cybdann/Hexapod/README.md

# Hexapod
A 6 six legged robot with 24 DoF, designed to be remotely controlled by an Android application.

Making of [Hexapod](https://youtu.be/HGF_E_Dyq9E).
