cybdann/Hexapod/MATLAB/horizontal.gif

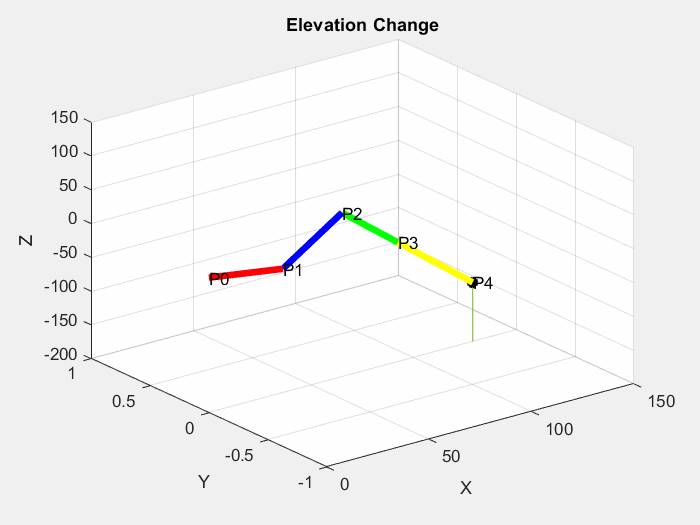
MATLAB/horizontal.gif
