cybdann/Hexapod/CAD Model/STL files/Body/BodyTopCasing2.stl

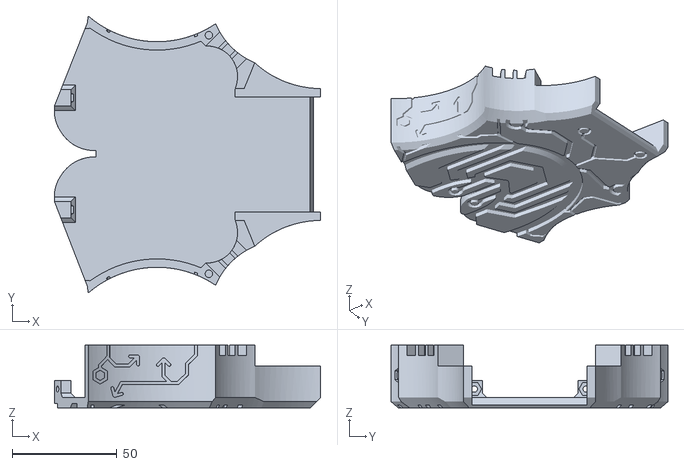
[picture p32: CAD file, 2022-01-12]
CAD Model/STL files/Body/BodyTopCasing2.stl
127.2 x 132.3 x 30.0
