cybdann/Hexapod/CAD Model/STL files/Leg Left Side/PistonTop.stl

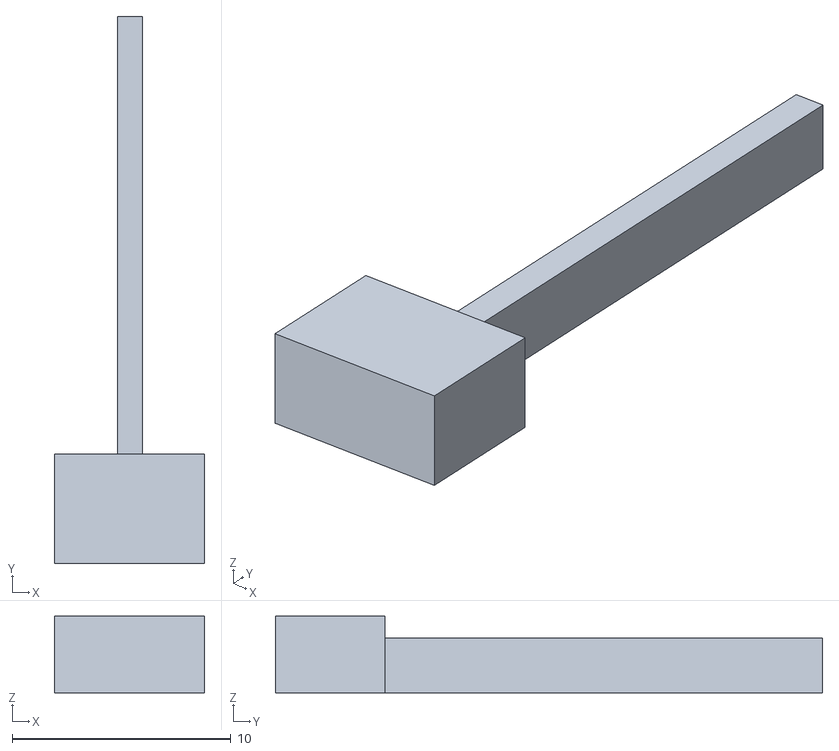
[picture p33: CAD file, 2022-01-12]
CAD Model/STL files/Leg Left Side/PistonTop.stl
6.85 x 25.0 x 3.50
