cybdann/Hexapod/CAD Model/STL files/Leg Right Side/PistonCasingTop.stl

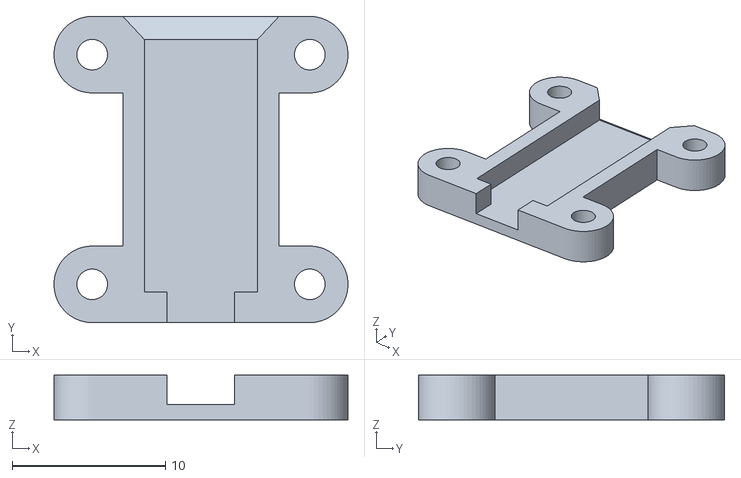
[picture p34: CAD file, 2022-01-12]
CAD Model/STL files/Leg Right Side/PistonCasingTop.stl
19.2 x 20.0 x 2.91
