cybdann/Hexapod/CAD Model/STL files/Body/BodyBotSup.stl

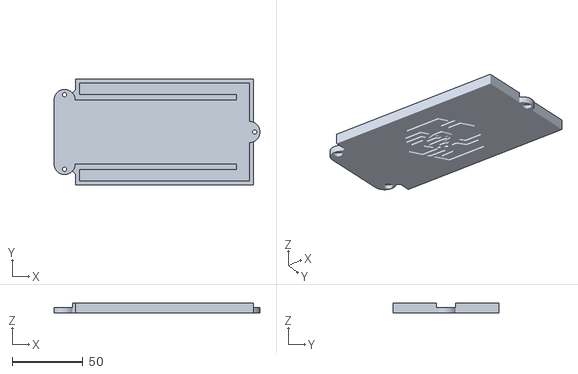
[picture p35: CAD file, 2022-01-12]
CAD Model/STL files/Body/BodyBotSup.stl
145.7 x 75.2 x 7.00
