cybdann/Hexapod/CAD Model/STL files/Leg Left Side/PistonBot.stl

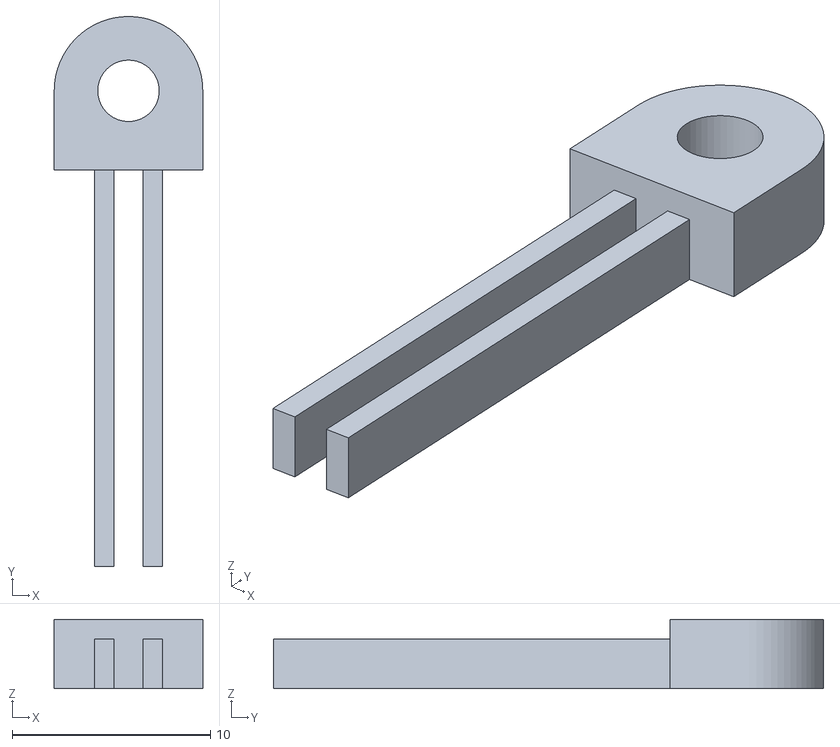
[picture p36: CAD file, 2022-01-12]
CAD Model/STL files/Leg Left Side/PistonBot.stl
7.50 x 27.8 x 3.50
