cybdann/Hexapod/CAD Model/STL files/Leg Right Side/PatellaTop.stl

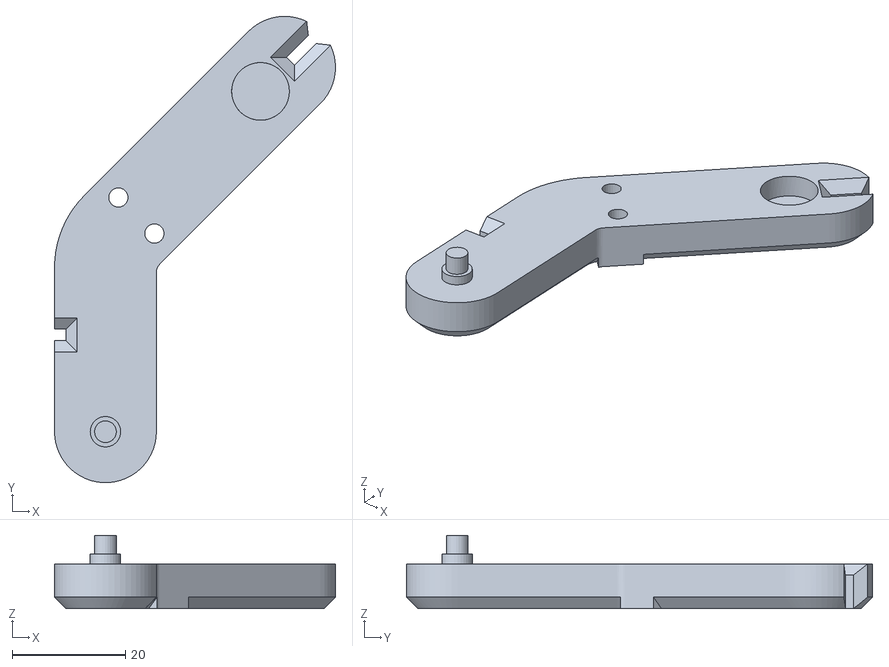
[picture p37: CAD file, 2022-01-12]
CAD Model/STL files/Leg Right Side/PatellaTop.stl
49.6 x 82.3 x 12.9
