cybdann/Hexapod/CAD Model/STL files/Body/PCBSupportTop.stl

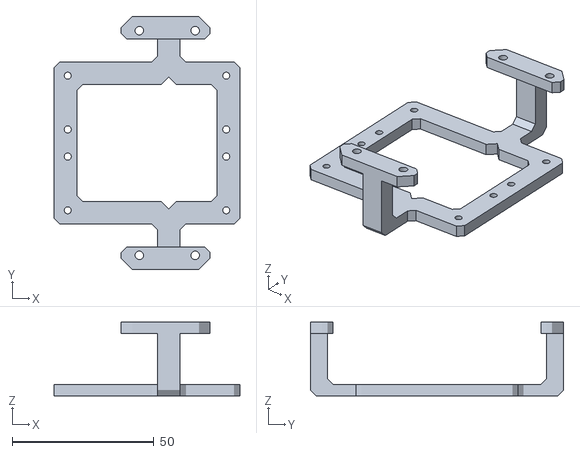
[picture p38: CAD file, 2022-01-12]
CAD Model/STL files/Body/PCBSupportTop.stl
65.6 x 89.4 x 26.0
