cybdann/Hexapod/CAD Model/STL files/Leg Right Side/Fibula.stl

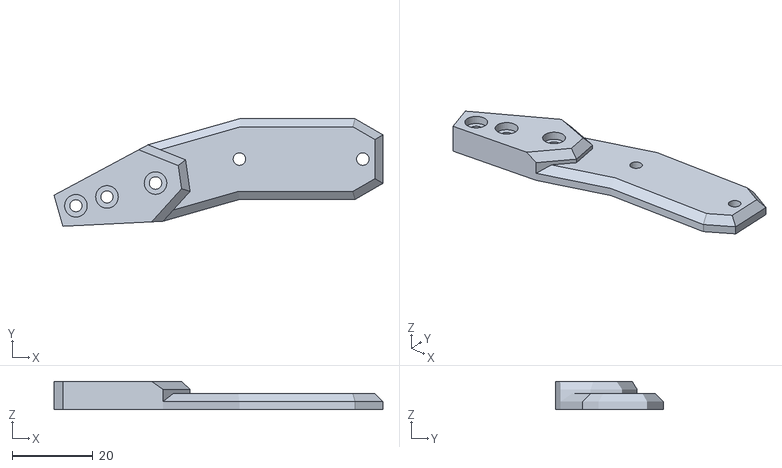
[picture p39: CAD file, 2022-01-12]
CAD Model/STL files/Leg Right Side/Fibula.stl
81.5 x 26.6 x 7.00
