cybdann/Hexapod/CAD Model/STL files/Body/BodyTopCasing1.stl

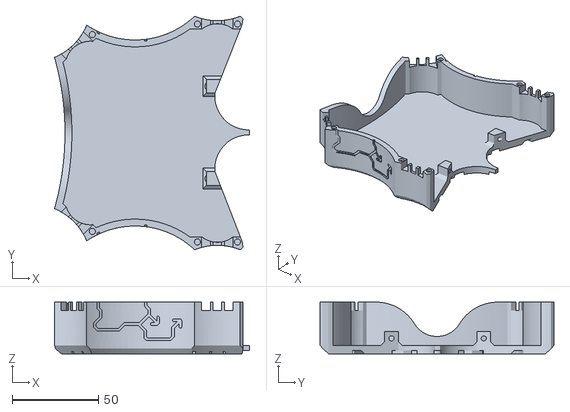
[picture p40: CAD file, 2022-01-12]
CAD Model/STL files/Body/BodyTopCasing1.stl
113.0 x 135.3 x 30.0
