cybdann/Hexapod/CAD Model/STL files/Body/BodyBot2.stl

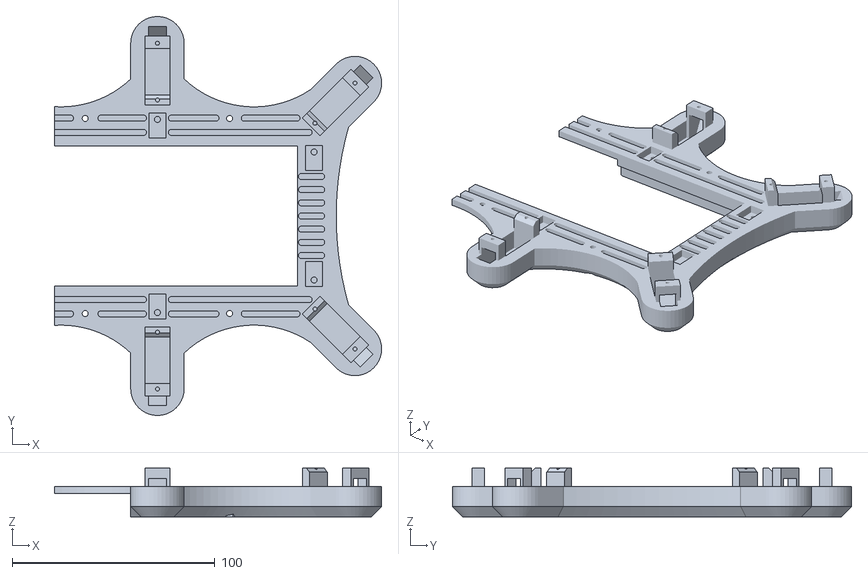
[picture p41: CAD file, 2022-01-12]
CAD Model/STL files/Body/BodyBot2.stl
161.6 x 197.0 x 24.0
