cybdann/Hexapod/CAD Model/STL files/Leg Left Side/Tibia Joint.stl

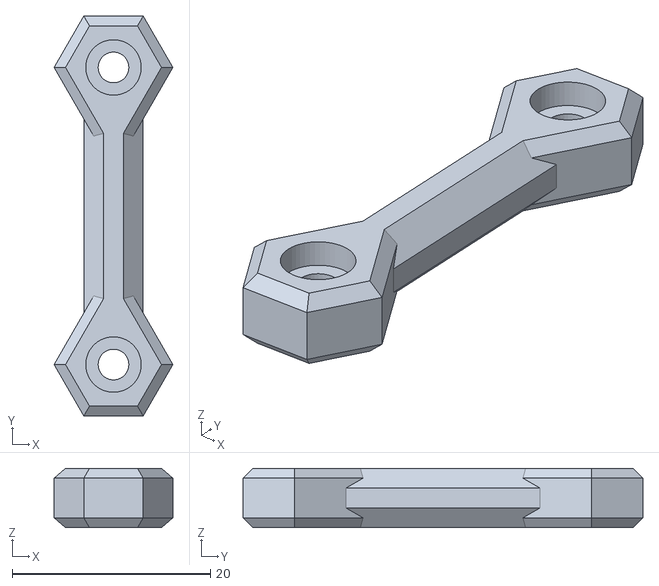
[picture p42: CAD file, 2022-01-12]
CAD Model/STL files/Leg Left Side/Tibia Joint.stl
12.0 x 40.4 x 6.00
