cybdann/Hexapod/CAD Model/STL files/Leg Right Side/FermurSupportSup.stl

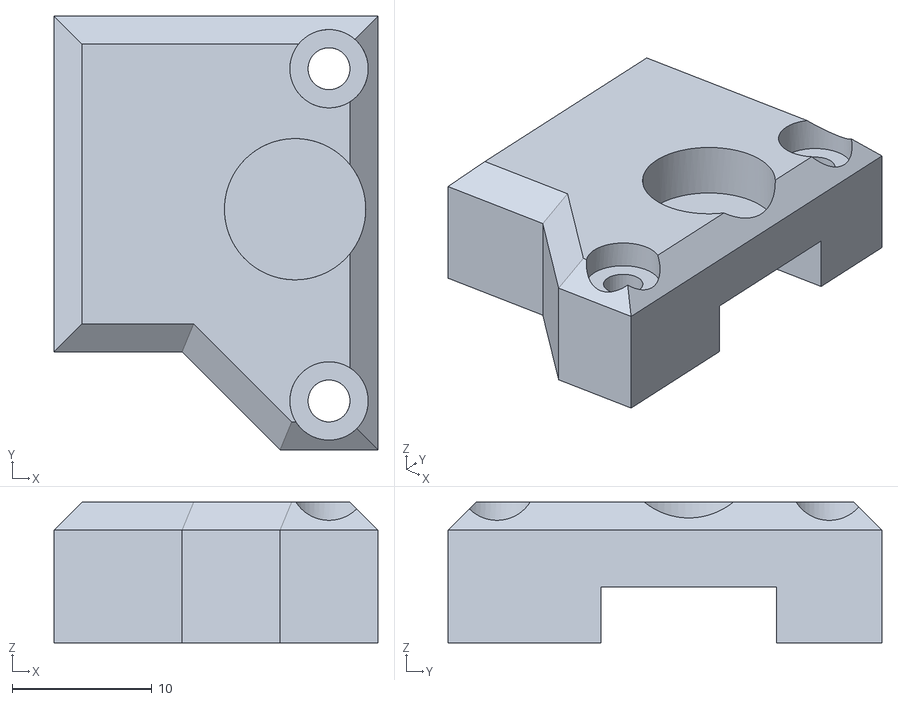
[picture p43: CAD file, 2022-01-12]
CAD Model/STL files/Leg Right Side/FermurSupportSup.stl
23.1 x 31.0 x 10.1
