cybdann/Hexapod/CAD Model/STL files/Body/BodyMid.stl

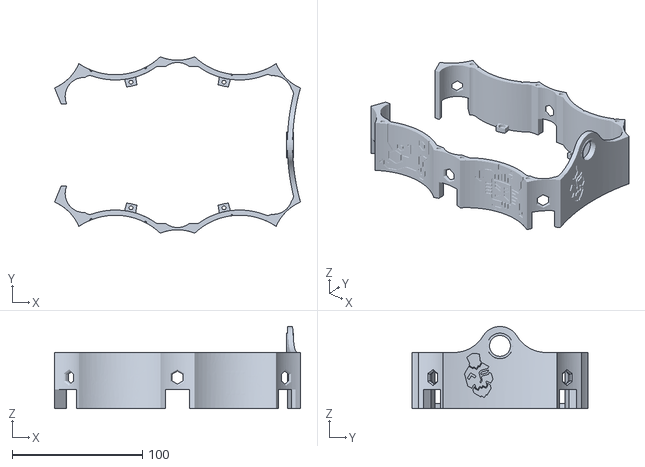
[picture p44: CAD file, 2022-01-12]
CAD Model/STL files/Body/BodyMid.stl
188.7 x 135.3 x 62.9
