cybdann/Hexapod/CAD Model/STL files/Leg Right Side/PatellaBot.stl

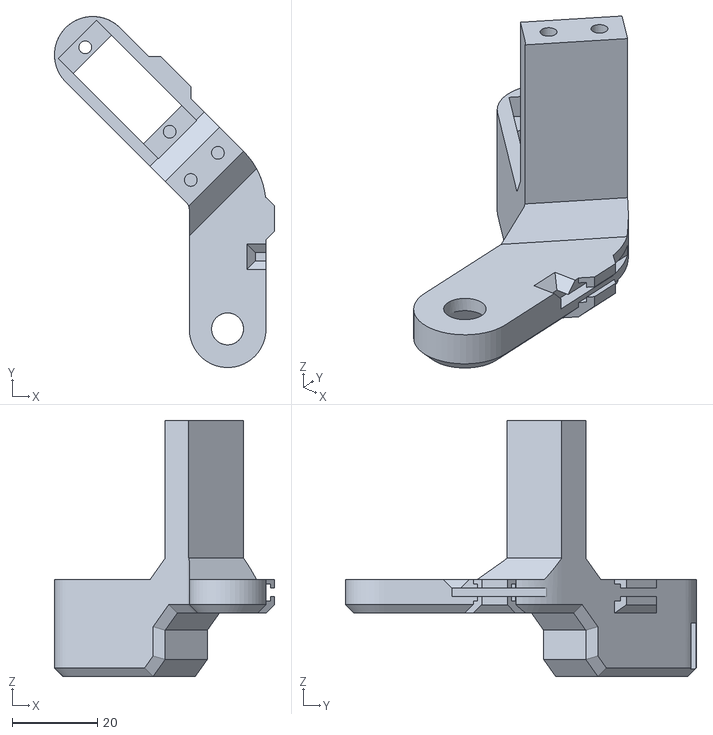
[picture p45: CAD file, 2022-01-12]
CAD Model/STL files/Leg Right Side/PatellaBot.stl
51.6 x 82.3 x 60.1
