cybdann/Hexapod/CAD Model/STL files/Body/BodyBot1.stl

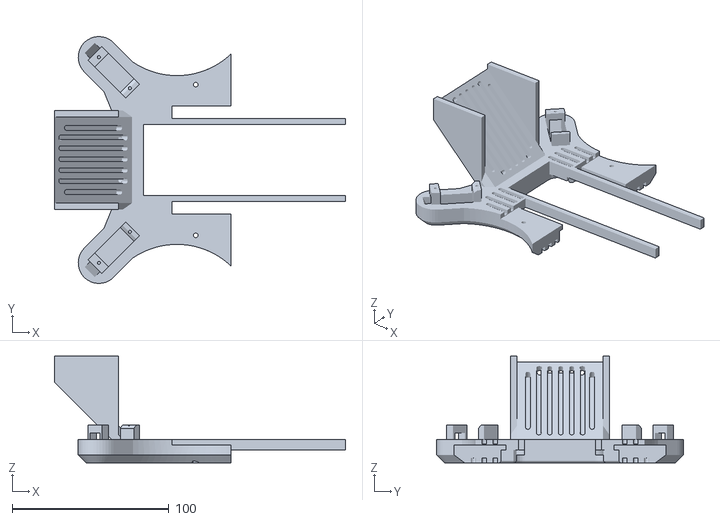
[picture p46: CAD file, 2022-01-12]
CAD Model/STL files/Body/BodyBot1.stl
185.8 x 157.6 x 68.0
