cybdann/Hexapod/CAD Model/STL files/Leg Left Side/FermurSupportLeft.stl

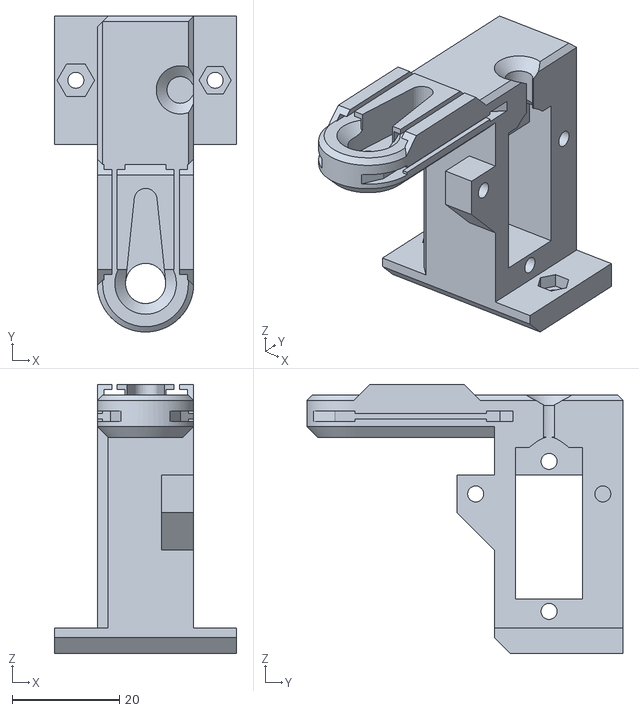
[picture p47: CAD file, 2022-01-12]
CAD Model/STL files/Leg Left Side/FermurSupportLeft.stl
34.0 x 59.0 x 50.3
