cybdann/Hexapod/CAD Model/STL files/Leg Right Side/PistonCasingPivot.stl

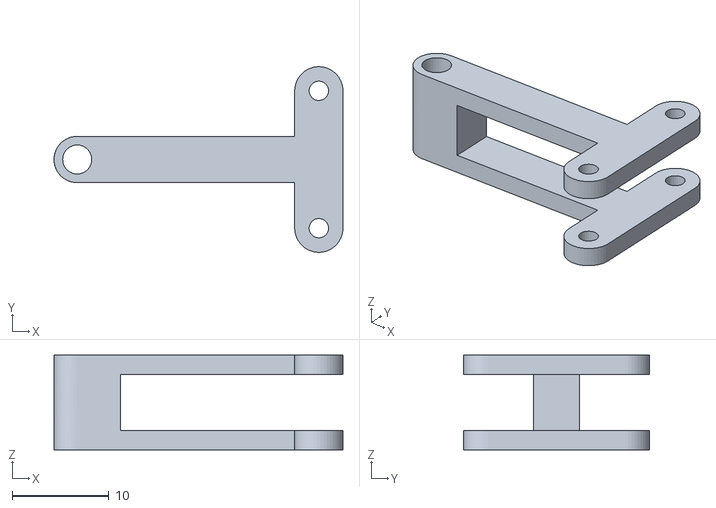
[picture p48: CAD file, 2022-01-12]
CAD Model/STL files/Leg Right Side/PistonCasingPivot.stl
29.9 x 19.2 x 9.81
