cybdann/Hexapod/CAD Model/STL files/Body/PCBSupportBot.stl

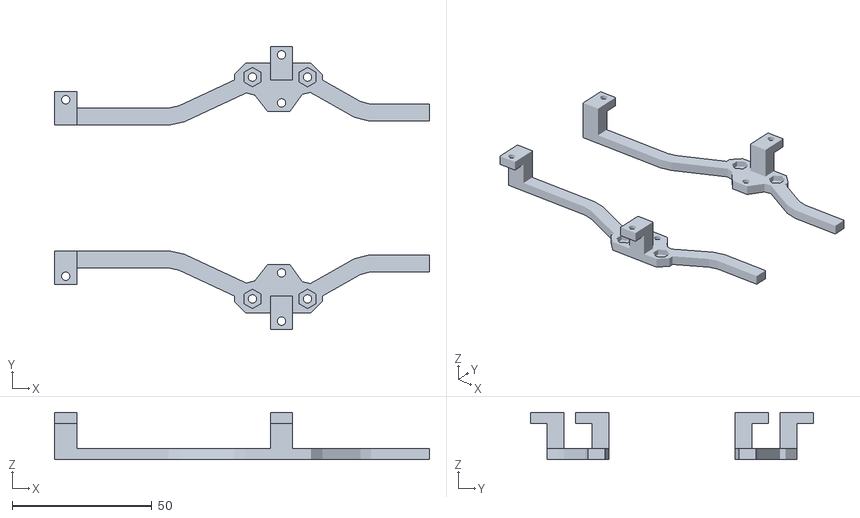
[picture p49: CAD file, 2022-01-12]
CAD Model/STL files/Body/PCBSupportBot.stl
134.3 x 101.4 x 17.0
