cybdann/Hexapod/CAD Model/STL files/Leg Right Side/FemurSupportBot.stl

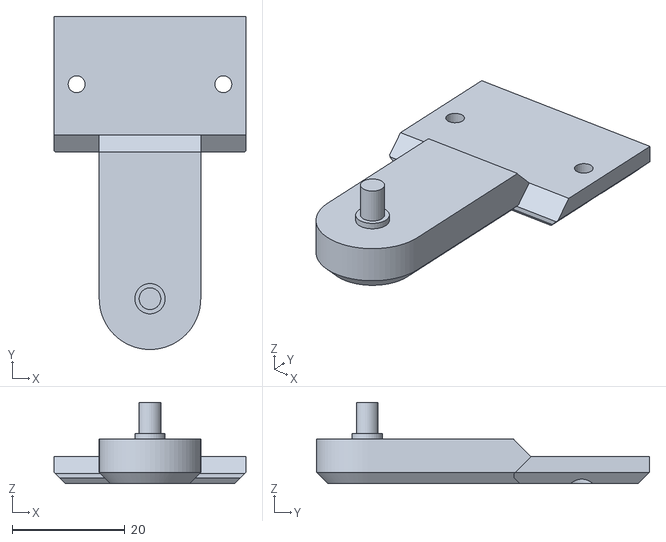
[picture p50: CAD file, 2022-01-12]
CAD Model/STL files/Leg Right Side/FemurSupportBot.stl
34.0 x 59.0 x 14.4
