cybdann/Hexapod/CAD Model/STL files/Leg Right Side/Tarsus.stl

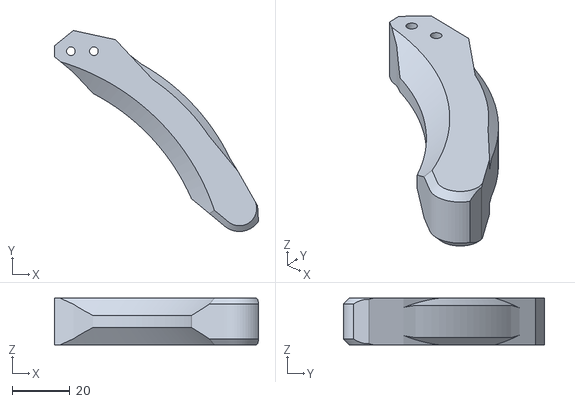
[picture p51: CAD file, 2022-01-12]
CAD Model/STL files/Leg Right Side/Tarsus.stl
70.9 x 69.8 x 16.2
