cybdann/Hexapod/CAD Model/STL files/Leg Right Side/TibiaTop.stl

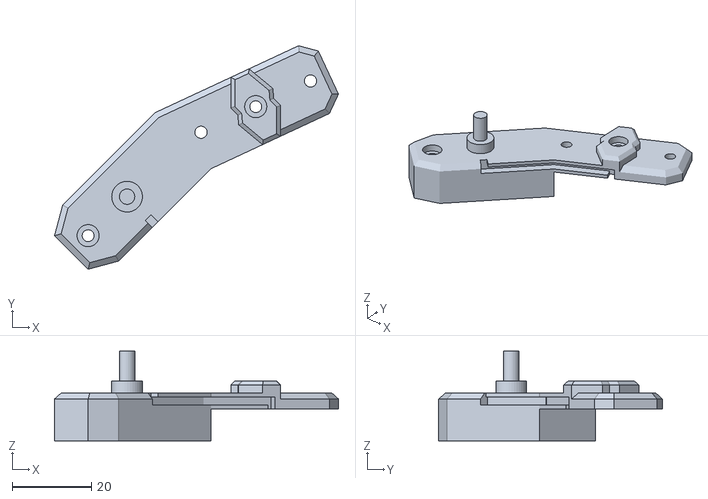
[picture p52: CAD file, 2022-01-12]
CAD Model/STL files/Leg Right Side/TibiaTop.stl
71.7 x 56.5 x 22.7
