cybdann/Hexapod/CAD Model/STL files/Leg Left Side/TibiaBotLeft.stl

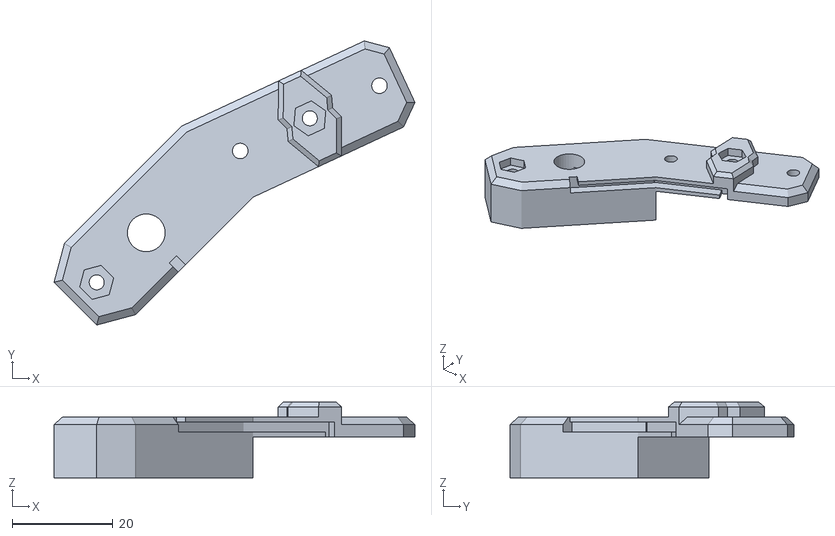
[picture p53: CAD file, 2022-01-12]
CAD Model/STL files/Leg Left Side/TibiaBotLeft.stl
71.7 x 56.5 x 15.1
