cybdann/Hexapod/(list of files, cad)

Other CAD files:
CAD Model/Inventor files/Templates/English/ANSI (in).dwg
CAD Model/Inventor files/Templates/Metric/ISO.dwg
CAD Model/Inventor files/Templates/standard.dwg
CAD Model/Inventor files/Templates/Metric/ANSI (mm).dwg
CAD Model/Inventor files/Templates/Metric/DIN.dwg
CAD Model/STL files/Leg Left Side/PatellaTopLeft.stl
CAD Model/Inventor files/Templates/Metric/BSI.dwg
CAD Model/STL files/Leg Right Side/PistonCasingBot.stl
CAD Model/Inventor files/Templates/Metric/JIS.dwg
CAD Model/Inventor files/Templates/Metric/GOST.dwg
CAD Model/STL files/Leg Left Side/FibulaBot.stl
CAD Model/Inventor files/Templates/Metric/GB.dwg
CAD Model/STL files/Leg Left Side/FermurSupportSupLeft.stl
CAD Model/STL files/Leg Left Side/PatellaBotLeft.stl
CAD Model/STL files/Leg Right Side/FibulaBot.stl
CAD Model/STL files/Leg Left Side/PistonCasingBot.stl
CAD Model/STL files/Leg Right Side/FermurSupport.stl
CAD Model/STL files/Leg Left Side/FemurSupportBotLeft.stl
CAD Model/STL files/Leg Right Side/TibiaBot.stl
CAD Model/STL files/Leg Left Side/TibiaTopLeft.stl
CAD Model/Inventor files/12Channel PWM.ipt
CAD Model/Inventor files/Bearing F 623 GB_T 7218-1995.ipt
CAD Model/Inventor files/Bearing FSN 718_5 GB_T 7218-1995.ipt
CAD Model/Inventor files/Bearing1.iam
CAD Model/Inventor files/Bearing1Left.iam
CAD Model/Inventor files/Bearing1Left1.iam
CAD Model/Inventor files/Bearing2.iam
CAD Model/Inventor files/Bearing2Left.iam
CAD Model/Inventor files/Bearing2Left1.iam
CAD Model/Inventor files/Bearing3.iam
CAD Model/Inventor files/Bearing4.iam
CAD Model/Inventor files/Bearing5.iam
CAD Model/Inventor files/Bearing6.iam
CAD Model/Inventor files/BodyBot.iam
CAD Model/Inventor files/BodyBot1.ipt
CAD Model/Inventor files/BodyBot2.ipt
CAD Model/Inventor files/BodyBotSup.ipt
CAD Model/Inventor files/BodyCasing.iam
CAD Model/Inventor files/BodyTop2.ipt
CAD Model/Inventor files/BodyTopCasing1.ipt
CAD Model/Inventor files/BodyTopCasing2.ipt
CAD Model/Inventor files/Bolted Connection1.iam
CAD Model/Inventor files/Bolted Connection10.iam
CAD Model/Inventor files/Bolted Connection10Left.iam
CAD Model/Inventor files/Bolted Connection10Left1.iam
CAD Model/Inventor files/Bolted Connection11.iam
CAD Model/Inventor files/Bolted Connection11Left.iam
CAD Model/Inventor files/Bolted Connection11Left1.iam
CAD Model/Inventor files/Bolted Connection12.iam
CAD Model/Inventor files/Bolted Connection12Left.iam
CAD Model/Inventor files/Bolted Connection12Left1.iam
CAD Model/Inventor files/Bolted Connection13.iam
CAD Model/Inventor files/Bolted Connection13Left.iam
CAD Model/Inventor files/Bolted Connection13Left1.iam
CAD Model/Inventor files/Bolted Connection14.iam
CAD Model/Inventor files/Bolted Connection14Left.iam
CAD Model/Inventor files/Bolted Connection14Left1.iam
CAD Model/Inventor files/Bolted Connection15.iam
CAD Model/Inventor files/Bolted Connection15Left.iam
CAD Model/Inventor files/Bolted Connection15Left1.iam
CAD Model/Inventor files/Bolted Connection16.iam
CAD Model/Inventor files/Bolted Connection16Left.iam
CAD Model/Inventor files/Bolted Connection16Left1.iam
CAD Model/Inventor files/Bolted Connection1Left.iam
CAD Model/Inventor files/Bolted Connection1Left1.iam
CAD Model/Inventor files/Bolted Connection2.iam
CAD Model/Inventor files/Bolted Connection2Left.iam
CAD Model/Inventor files/Bolted Connection2Left1.iam
CAD Model/Inventor files/Bolted Connection3.iam
CAD Model/Inventor files/Bolted Connection3Left.iam
CAD Model/Inventor files/Bolted Connection3Left1.iam
CAD Model/Inventor files/Bolted Connection4.iam
CAD Model/Inventor files/Bolted Connection4Left.iam
CAD Model/Inventor files/Bolted Connection4Left1.iam
CAD Model/Inventor files/Bolted Connection5.iam
CAD Model/Inventor files/Bolted Connection5Left.iam
CAD Model/Inventor files/Bolted Connection5Left1.iam
CAD Model/Inventor files/Bolted Connection6.iam
CAD Model/Inventor files/Bolted Connection6Left.iam
CAD Model/Inventor files/Bolted Connection6Left1.iam
CAD Model/Inventor files/Bolted Connection7.iam
CAD Model/Inventor files/Bolted Connection7Left.iam
CAD Model/Inventor files/Bolted Connection7Left1.iam
CAD Model/Inventor files/Bolted Connection8.iam
CAD Model/Inventor files/Bolted Connection8Left.iam
CAD Model/Inventor files/Bolted Connection8Left1.iam
CAD Model/Inventor files/Bolted Connection9.iam
CAD Model/Inventor files/Bolted Connection9Left.iam
CAD Model/Inventor files/Bolted Connection9Left1.iam
CAD Model/Inventor files/Compress Spring1.iam
CAD Model/Inventor files/Compress Spring11.ipt
CAD Model/Inventor files/Compress Spring11Left.ipt
CAD Model/Inventor files/Compress Spring11Left1.ipt
CAD Model/Inventor files/Compress Spring1Left.iam
CAD Model/Inventor files/Compress Spring1Left1.iam
CAD Model/Inventor files/Design Data/AIT/Mold Design/mold design stop pin.ipt
CAD Model/Inventor files/Design Data/Cable & Harness/en-US/harness.iam
CAD Model/Inventor files/Design Data/Tube & Pipe/en-US/piping runs.iam
CAD Model/Inventor files/FemurSupportBot.ipt
CAD Model/Inventor files/FemurSupportBotLeft.ipt
CAD Model/Inventor files/FemurSupportBotLeft1.ipt
CAD Model/Inventor files/Fermur.iam
CAD Model/Inventor files/FermurLeft.iam
CAD Model/Inventor files/FermurLeft1.iam
CAD Model/Inventor files/FermurSupport.ipt
CAD Model/Inventor files/FermurSupportLeft.ipt
CAD Model/Inventor files/FermurSupportLeft1.ipt
CAD Model/Inventor files/FermurSupportSup.ipt
CAD Model/Inventor files/FermurSupportSupLeft.ipt
CAD Model/Inventor files/FermurSupportSupLeft1.ipt
CAD Model/Inventor files/Fibula.ipt
CAD Model/Inventor files/FibulaBot.ipt
CAD Model/Inventor files/FibulaBotLeft.ipt
CAD Model/Inventor files/FibulaBotLeft1.ipt
CAD Model/Inventor files/FibulaLeft.ipt
CAD Model/Inventor files/FibulaLeft1.ipt
CAD Model/Inventor files/ISO 4035 - M2 - ISO.ipt
CAD Model/Inventor files/ISO 4035 - M3 - ISO.ipt
CAD Model/Inventor files/ISO 4762 - M3 x 12ISO.ipt
CAD Model/Inventor files/ISO 4762 - M3 x 16ISO.ipt
CAD Model/Inventor files/ISO 4762 - M3 x 20ISO.ipt
CAD Model/Inventor files/ISO 4762 - M3 x 25ISO.ipt
CAD Model/Inventor files/ISO 4762 - M3 x 30ISO.ipt
CAD Model/Inventor files/ISO 4762 - M3 x 5ISO.ipt
CAD Model/Inventor files/ISO 4762 - M3 x 6ISO.ipt
CAD Model/Inventor files/ISO 4762 - M3 x 8ISO.ipt
CAD Model/Inventor files/ISO 7045 - M2 x 12 - 4.8 - H - ISO.ipt
CAD Model/Inventor files/ISO 7045 - M2 x 4 - 4.8 - H - ISO.ipt
CAD Model/Inventor files/ISO 7045 - M2 x 6 - 4.8 - H - ISO.ipt
CAD Model/Inventor files/ISO 7045 - M2 x 8 - 4.8 - H - ISO.ipt
CAD Model/Inventor files/LegDemoRight.iam
CAD Model/Inventor files/LegDemoRightLeft.iam
CAD Model/Inventor files/LegDemoRightLeft1.iam
CAD Model/Inventor files/LegMidBot.ipt
CAD Model/Inventor files/LegMidTop.ipt
CAD Model/Inventor files/New Logo Rage.ipt
CAD Model/Inventor files/New Logo.ipt
CAD Model/Inventor files/OldVersions/Bolted Connection1.0001.iam
CAD Model/Inventor files/OldVersions/Bolted Connection2.0001.iam
CAD Model/Inventor files/OldVersions/Bolted Connection3.0002.iam
CAD Model/Inventor files/OldVersions/Bolted Connection5.0001.iam
CAD Model/Inventor files/OldVersions/Compress Spring11.0013.ipt
CAD Model/Inventor files/OldVersions/FemurSupportBot.0064.ipt
CAD Model/Inventor files/OldVersions/FemurSupportBotLeft1.0001.ipt
CAD Model/Inventor files/OldVersions/Fermur.0063.iam
CAD Model/Inventor files/OldVersions/FermurLeft.0002.iam
CAD Model/Inventor files/OldVersions/FermurLeft1.0001.iam
CAD Model/Inventor files/OldVersions/FermurSupport.0077.ipt
CAD Model/Inventor files/OldVersions/FermurSupportLeft.0001.ipt
CAD Model/Inventor files/OldVersions/FermurSupportLeft1.0001.ipt
CAD Model/Inventor files/OldVersions/FermurSupportSup.0070.ipt
CAD Model/Inventor files/OldVersions/FermurSupportSupLeft1.0001.ipt
CAD Model/Inventor files/OldVersions/Fibula.0024.ipt
CAD Model/Inventor files/OldVersions/FibulaBot.0017.ipt
CAD Model/Inventor files/OldVersions/HexapodShelled.0015.iam
CAD Model/Inventor files/OldVersions/LegDemoRight.0355.iam
CAD Model/Inventor files/OldVersions/LegDemoRight.0356.iam
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
