cybdann/Hexapod/ESP32/gaits.py

# Vertical movement angles
vm_R1C = (67, 70, 73, 77, 80, 83, 86, 90, 93, 97, 100, 104, 107, 111, 110, 109, 108, 107, 105, 104, 102, 101, 99, 97, 94, 92, 89, 86, 83, 79, 75, 71, 66, 61, 56, 51, 45, 40, 35, 37, 39, 41, 44, 47, 49, 52, 55, 58, 61, 64)
vm_R1F = (152, 149, 145, 141, 137, 133, 128, 123, 117, 111, 104, 97, 89, 81, 83, 85, 86, 87, 88, 89, 90, 90, 91, 91, 91, 91, 91, 91, 91, 91, 90, 90, 90, 89, 89, 89, 89, 89, 89, 103, 116, 129, 140, 148, 154, 158, 159, 158, 157, 154)
vm_R1T = (106, 103, 100, 97, 94, 92, 89, 86, 83, 80, 76, 72, 67, 62, 65, 68, 71, 74, 77, 79, 82, 84, 86, 88, 90, 91, 93, 94, 95, 96, 97, 97, 98, 98, 99, 99, 99, 99, 99, 106, 113, 118, 122, 124, 124, 123, 120, 117, 114, 110)

vm_R2C = (89, 92, 95, 98, 101, 105, 108, 111, 114, 117, 121, 124, 127, 131, 128, 126, 123, 120, 117, 114, 111, 107, 104, 100, 96, 92, 89, 85, 81, 77, 74, 70, 67, 64, 61, 58, 55, 53, 50, 54, 57, 60, 64, 67, 70, 73, 76, 80, 83, 86)
vm_R2F = (140, 140, 139, 138, 137, 135, 133, 130, 125, 120, 114, 106, 98, 89, 90, 90, 91, 91, 91, 91, 91, 91, 91, 91, 91, 91, 91, 91, 91, 91, 91, 91, 91, 91, 91, 91, 90, 90, 89, 98, 106, 114, 120, 125, 130, 133, 135, 137, 138, 139)
vm_R2T = (93, 93, 94, 94, 94, 95, 95, 95, 95, 94, 92, 89, 85, 81, 83, 84, 86, 87, 88, 89, 90, 91, 91, 92, 92, 92, 92, 92, 92, 91, 91, 90, 89, 88, 87, 86, 84, 83, 81, 85, 89, 92, 94, 95, 95, 95, 95, 94, 94, 94)

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

em_L3F = (26, 35, 42, 49, 55, 60, 65, 70, 74, 79, 83, 87, 91, 94, 98, 102, 105, 109, 112, 116, 119, 123, 126, 130, 133)
em_L3T = (44, 50, 54, 58, 62, 66, 70, 73, 76, 80, 83, 86, 90, 93, 96, 99, 103, 106, 110, 113, 117, 120, 124, 128, 132)
