cybdann/Hexapod/(commit log)

2021-12-30 CAD Model
    Files created in Inventor
    [12Channel PWM.ipt, ANSI (in).dwg, ANSI (in).idw, ANSI (mm).dwg, ANSI (mm).idw, BSI.dwg, BSI.idw, Bearing F 623 GB_T 7218-1995.ipt]
2021-12-31 MATLAB files
    Files for path and trajectory planning with leg simulations
2021-12-31 ESP32
    MCU MicroPython files for Hexapod control
2022-01-02 Kinematics fix
    Updated kinematics equations and parameters for accurate model representation
2022-01-12 STL files
    Generated .stl files for 3D printing
    [12Channel PWM.ipt, ANSI (in).dwg, ANSI (in).idw, ANSI (mm).dwg, ANSI (mm).idw, BSI.dwg, BSI.idw, Bearing F 623 GB_T 7218-1995.ipt]
2022-01-12 Gait path simulation
    Added path simulation for every leg
2022-03-05 Gait model following
    Modified the control thread of the software
    Control of the Hexapod is done through the following of pre-calculated angles from tuples
